vasjamarkic/EVNikola-SOC-meter-ArduinoNano-OLED-display/connecting-SOCMeter-to-cell-load-charger-shunt.jpg

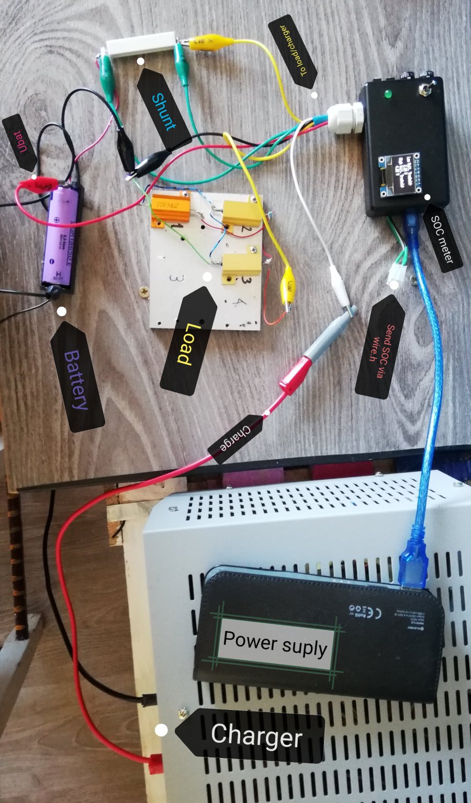
connecting-SOCMeter-to-cell-load-charger-shunt.jpg
