vasjamarkic/EVNikola-SOC-meter-ArduinoNano-OLED-display/README.md

# EVNikola project - Elec3go Institute, SOC Meter
Solutions for electric vehicle development with Arduino, Nextion and other open-source technologies, 
current working on portable SOC meter with Arduino Nano and OLED display. 

Vasja Markič,
CEO of the Elec3go Institute, SI.
