vasjamarkic/EVNikola-SOC-meter-ArduinoNano-OLED-display/sheme_SOC_Meter_NanoArduino_OLED_display.PNG

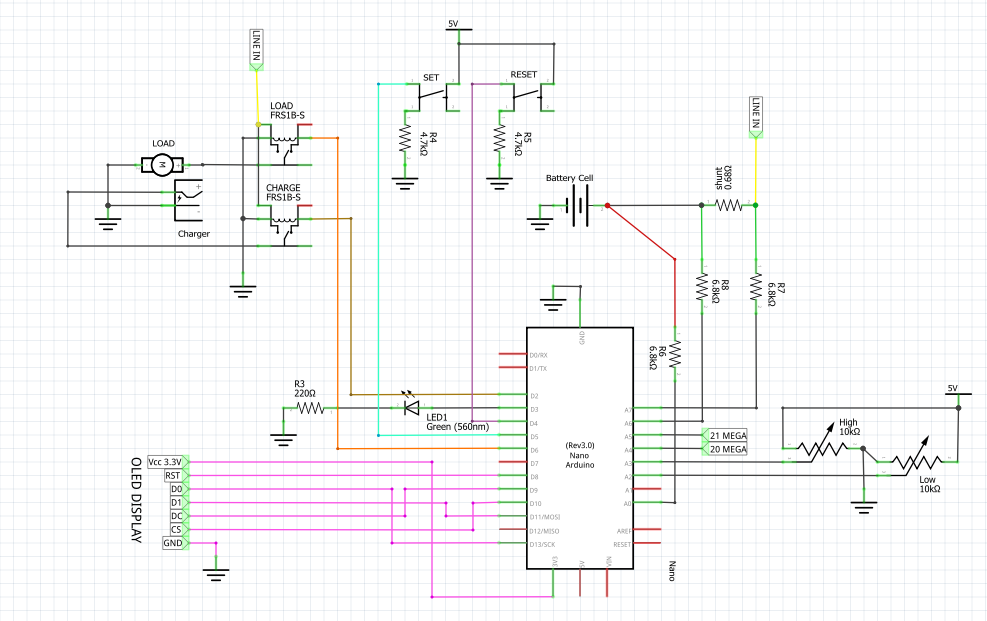
sheme_SOC_Meter_NanoArduino_OLED_display.PNG
