vasjamarkic/EVNikola-SOC-meter-ArduinoNano-OLED-display/(list of files, drawings)

Other design files:
SPI_OLED_NANO_battery_SOC_meter_fritzing.fzz
