vasjamarkic/EVNikola-SOC-meter-ArduinoNano-OLED-display/(commit log)

2018-08-18 SOC meter with Arduino Nano
    The circuit works in two ways;
    a) Measure ONLY the state of charge (SOC) for a cell of max 5V,
    b) Measure the SOC and enable charge or discharge the cell with two integrated relays.
    Green connectors "A6" & "A7" are placed on shunt resistor, red connector on + of the battery cell, black connector on GND. When on mode (b), black connector is placed on GND charger and GND load, the yellow "load" connector on + of the load and the yellow "line in" on the exit of the shunt resistor (with the green "A7" connector). There is a data cable/connector that sends via <wire.h> the integer SOC to the other Arduino Mega, where can be displayed graphical with the Nextion di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
    [SPI_OLED_NANO_battery_SOC_meter_fritzing.fzz]
2018-08-18 Updated the code, with instructions
    Added info for wiring the device with the cell, charger, load and shunt.
2018-08-18 Connection picture
    How to connect the SOC meter with the battery cell/pack, chunt, charger and load.
2018-08-18 Wiring scheme SOC meter
    Arduino Nano and OLED display Adafruit, wiring drawing
2018-08-18 Old one ..
    [SPI_OLED_NANO_battery_SOC_meter_fritzing.fzz]
2018-08-25 Charge/discharge module for battery
    from Ebay
